SphereEGS/Sphere-X-Extension/Electronics/Step file/PCB.step

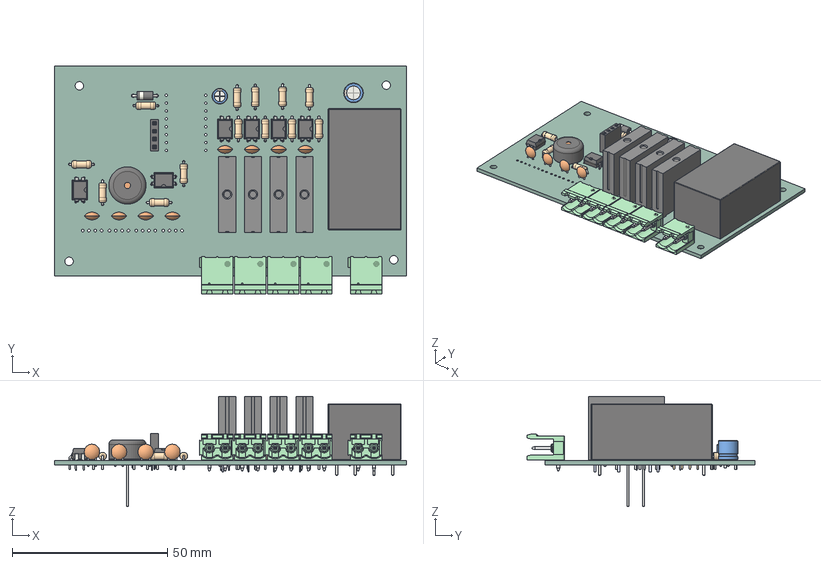
[picture p1: CAD file, 2025-05-03]
Electronics/Step file/PCB.step
113.3 x 73.2 x 35.5 mm
C_Disc_D5.0mm_W2.5mm_P2.50mm x 8
R_Axial_DIN0207_L6.3mm_D2.5mm_P7.62mm_Horizontal x 13
PinSocket_1x04_P2.54mm_Vertical
DIP-4_W7.62mm x 6
Converter_ACDC_Hi-Link_HLK-5Mxx
G3MB-202P x 4
Buzzer_TDK_PS1240P02BT_D12.2mm_H6.5mm
pin_01 x 5
pin_02 x 5
CP_Radial_D5.0mm_P2.50mm
D_DO-41_SOD81_P7.62mm_Horizontal
CP_Radial_D6.3mm_P2.50mm
Electronics_PCB
