SphereEGS/Sphere-X-Extension/Electronics/PDF/silk.pdf

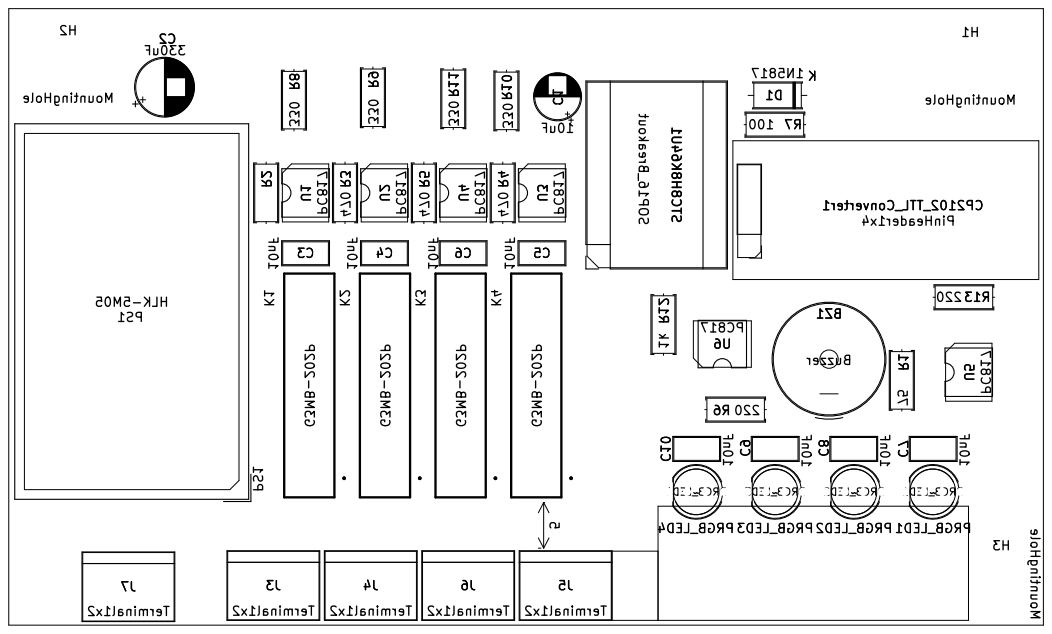
[picture p2: page 1]
