SphereEGS/Sphere-X-Extension/Electronics/PDF/trace.pdf

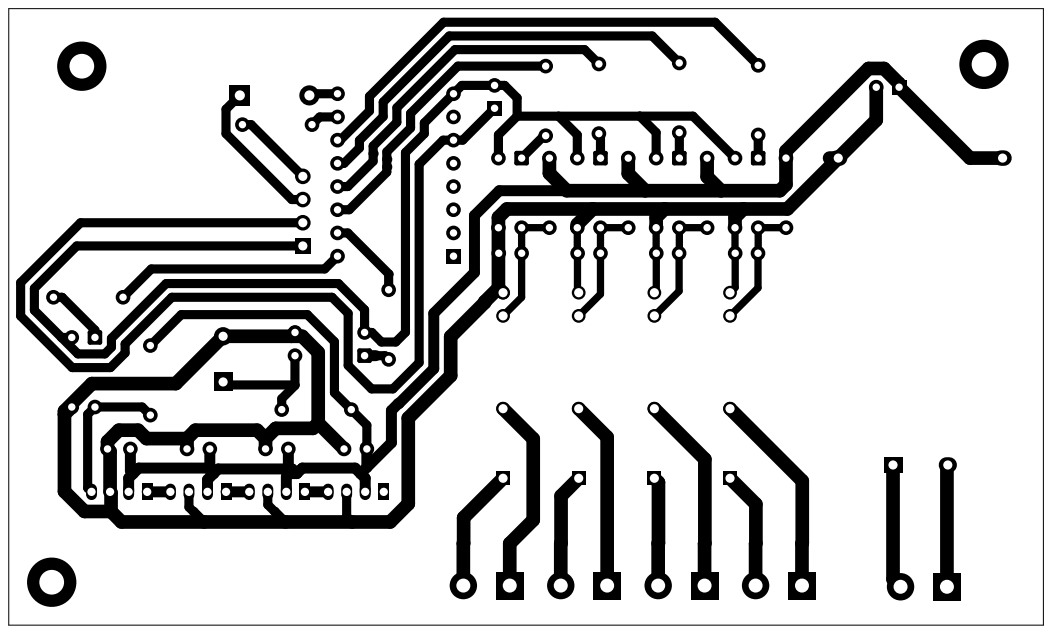
[picture p3: page 1]
