SphereEGS/Sphere-X-Extension/Electronics/Electronics.kicad_pcb

## KiCad design Electronics/Electronics.kicad_pcb (2025-05-08)

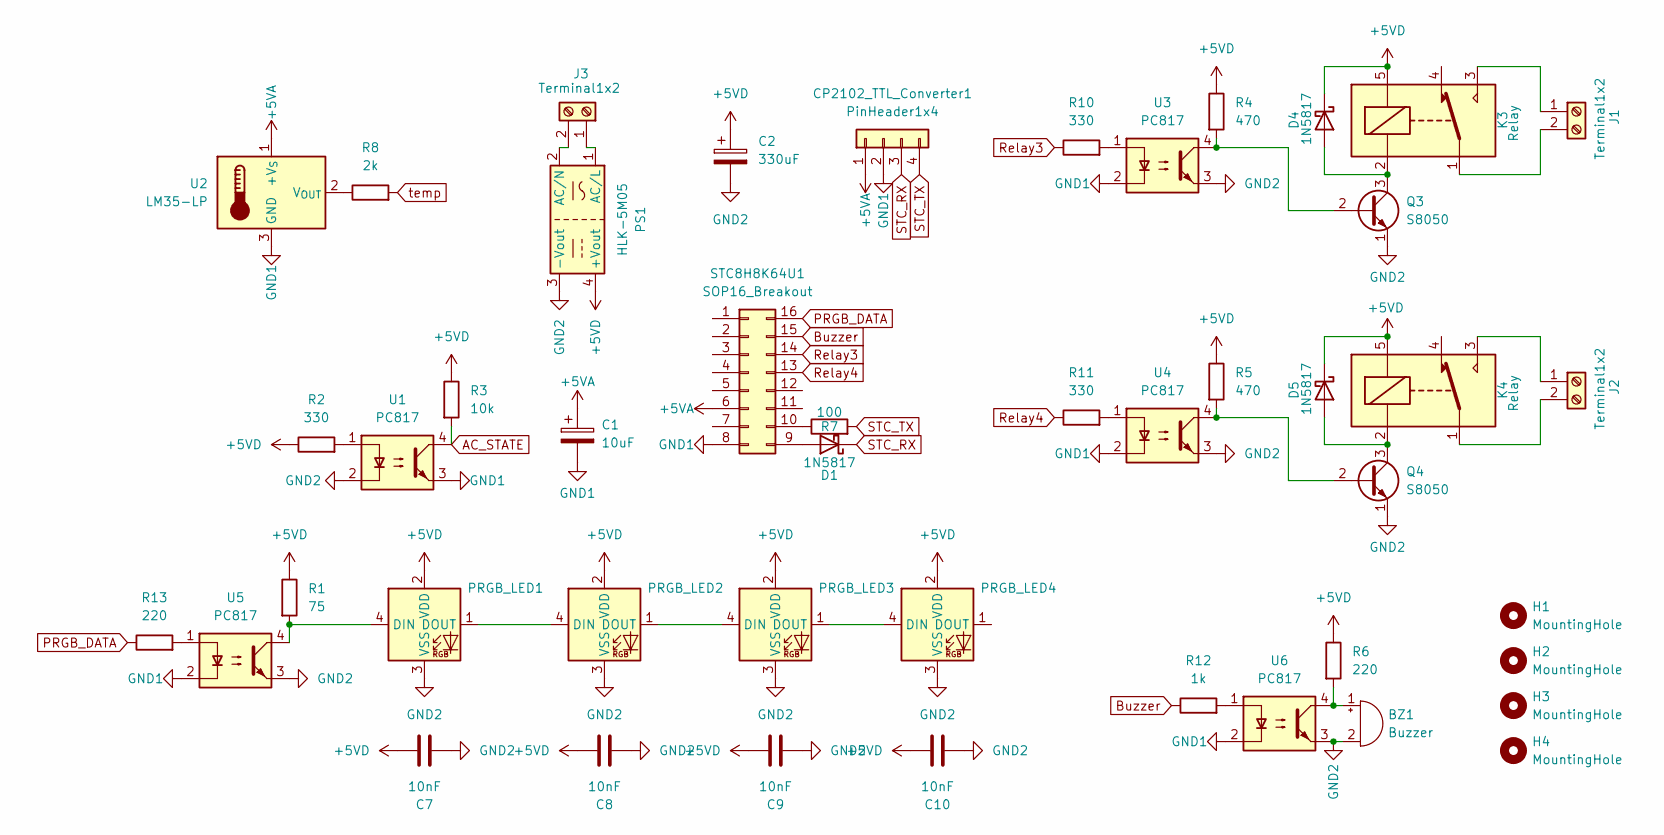
[picture p4: schematic Electronics.kicad_sch]

Parts:
BZ1: Buzzer; Buzzer_TDK_PS1240P02BT_D12.2mm_H6.5mm
C1: 10uF; CP_Radial_D5.0mm_P2.50mm
C2: 330uF; CP_Radial_D6.3mm_P2.50mm
C7, C8, C9, C10: 10nF; C_Disc_D5.0mm_W2.5mm_P2.50mm
CP2102_TTL_Converter1: PinHeader1x4; PinSocket_1x04_P2.54mm_Vertical
D1, D4, D5: 1N5817; D_DO-41_SOD81_P7.62mm_Horizontal
H1, H2, H3, H4: MountingHole; MountingHole_2.7mm_Pad
J1, J2, J3: Terminal1x2; TerminalBlock_bornier-2_P5.08mm
K3, K4: Relay; Relay_SPDT_SANYOU_SRD_Series_Form_C
PRGB_LED1, PRGB_LED2, PRGB_LED3, PRGB_LED4: PRGB_LED_DIP_Wide
PS1: HLK-5M05; Converter_ACDC_Hi-Link_HLK-5Mxx
Q3, Q4: S8050; TO-92_Inline_Wide
R1: 75; R_Axial_DIN0207_L6.3mm_D2.5mm_P7.62mm_Horizontal
R2, R10, R11: 330; R_Axial_DIN0207_L6.3mm_D2.5mm_P7.62mm_Horizontal
R3: 10k; R_Axial_DIN0207_L6.3mm_D2.5mm_P7.62mm_Horizontal
R4, R5: 470; R_Axial_DIN0207_L6.3mm_D2.5mm_P7.62mm_Horizontal
R6, R13: 220; R_Axial_DIN0207_L6.3mm_D2.5mm_P7.62mm_Horizontal
R7: 100; R_Axial_DIN0207_L6.3mm_D2.5mm_P7.62mm_Horizontal
R8: 2k; R_Axial_DIN0207_L6.3mm_D2.5mm_P7.62mm_Horizontal
R12: 1k; R_Axial_DIN0207_L6.3mm_D2.5mm_P7.62mm_Horizontal
STC8H8K64U1: SOP16_Breakout; Pololu_Breakout-16_15.2x20.3mm
U1, U3, U4, U5, U6: PC817; DIP-4_W7.62mm
U2: LM35-LP; TO-92L_Inline_Wide

Connections:
+5VA: C1.1, CP2102_TTL_Converter1.1, STC8H8K64U1.6, U2.1 (+V_{S})
+5VD: C2.1, C7.2, C8.2, C9.2, C10.2, D4.1 (K), D5.1 (K), K3.5, K4.5, PRGB_LED1.2 (VDD), PRGB_LED2.2 (VDD), PRGB_LED3.2 (VDD), PRGB_LED4.2 (VDD), PS1.4 (+Vout), R1.1, R2.1, R3.1, R4.1, R5.1, R6.1
AC_STATE: R3.2, U1.4
Buzzer: R12.1, STC8H8K64U1.15
GND1: C1.2, CP2102_TTL_Converter1.2, STC8H8K64U1.8, U1.3, U2.3 (GND), U3.2, U4.2, U5.2, U6.2
GND2: BZ1.2 (-), C2.2, C7.1, C8.1, C9.1, C10.1, PRGB_LED1.3 (VSS), PRGB_LED2.3 (VSS), PRGB_LED3.3 (VSS), PRGB_LED4.3 (VSS), PS1.3 (-Vout), Q3.1 (E), Q4.1 (E), U1.2, U3.3, U4.3, U5.3, U6.3
unnamed: BZ1.1 (+), R6.2, U6.4
unnamed: D1.2 (A), STC8H8K64U1.9
unnamed: D4.2 (A), K3.2, Q3.3 (C)
unnamed: D5.2 (A), K4.2, Q4.3 (C)
unnamed: J1.1, K3.3
unnamed: J1.2, K3.1
unnamed: J2.1, K4.3
unnamed: J2.2, K4.1
unnamed: J3.1, PS1.1 (AC/L)
unnamed: J3.2, PS1.2 (AC/N)
unnamed: PRGB_LED1.4 (DIN), R1.2, U5.4
unnamed: PRGB_LED1.1 (DOUT), PRGB_LED2.4 (DIN)
unnamed: PRGB_LED2.1 (DOUT), PRGB_LED3.4 (DIN)
unnamed: PRGB_LED3.1 (DOUT), PRGB_LED4.4 (DIN)
unnamed: Q3.2 (B), R4.2, U3.4
unnamed: Q4.2 (B), R5.2, U4.4
unnamed: R2.2, U1.1
unnamed: R10.2, U3.1
unnamed: R11.2, U4.1
unnamed: R12.2, U6.1
unnamed: R13.2, U5.1
unnamed: R7.1, STC8H8K64U1.10
unnamed: R8.1, U2.2 (V_{OUT})
PRGB_DATA: R13.1, STC8H8K64U1.16
Relay3: R10.1, STC8H8K64U1.14
Relay4: R11.1, STC8H8K64U1.13
STC_RX: CP2102_TTL_Converter1.3, D1.1 (K)
STC_TX: CP2102_TTL_Converter1.4, R7.2
temp: R8.2

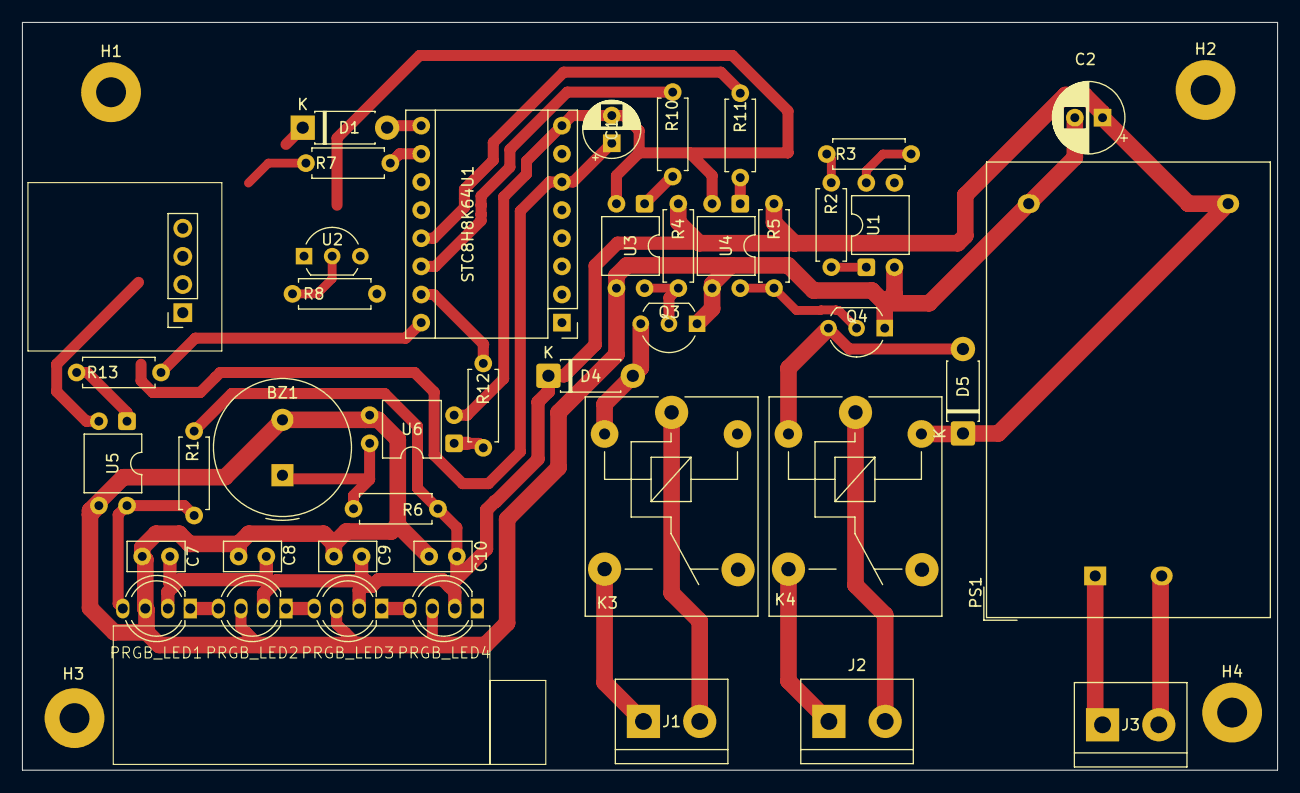
[picture p5: board Electronics.kicad_pcb from above]

Board: 2 copper layers, 113.3 x 67.5 mm, 46 parts (0 on the bottom side), 34 nets.
