SphereEGS/Sphere-X-Extension/Programming/stc_programming/terminal.c

#include "project-defs.h"

static command_t command;

// reads int only not floats and increments the char_count to the index of after the number
bool read_int(char *line, uint8_t* char_count, int16_t* int_value_ptr) {

  char *ptr = line + *char_count; // the variable that will extract the next digit from
  unsigned char c; // the variable that will hold each digit

  c = *ptr++;  // extracting the next digit!

  // catching negative values :)
  bool isnegative = false;
  if (c == '-') {
    isnegative = true;
    c = *ptr++;

  // incrementing pointer anyway if +ve sign is there
  } else if (c == '+') {
    c = *ptr++;
  }

  // Algorithm to convert char digits to int
  uint32_t intval = 0;
  uint8_t ndigit = 0;  // current digit read index
  int8_t exp = 0;  // NOT uint8_t as this must hold +ve and -ve numbers
  while (1) {

    c -= '0';
    if (c <= 9) {
      ndigit++;
      if (ndigit <= MAX_INT_DIGITS) {

        intval = (((intval << 2) + intval) << 1) + c; // intval*10 + c
                                                      //
      } else {

        exp++;  // Drop overflow digits
      }

    } else {
      // encountered a non integer character
      break;
    }
    c = *ptr++;
  }

  // Return if no digits have been read.
  if (!ndigit) { return(false); };

  long int lival;
  lival = (long int)intval;
  
  if (exp > 0) {
    do {
      lival *= 10.0;
    } while (--exp > 0);
  } 

  // Assign floating point value with correct sign.    
  if (isnegative) {
    *int_value_ptr = -lival;
  } else {
    *int_value_ptr = lival;
  }

  *char_count = ptr - line - 1; // Set char_counter to next statement
 
  return (true);
}

void command_reset(command_t* command) {
  command->command_type = COMMAND_NOT_SET;
  command->i = INT_ARGS_DEFAULT;
  command->j = INT_ARGS_DEFAULT;
  command->command_modal_status = COMMAND_NON_MODAL;
}

LINE_STATUS terminal_execute_line(char* line) {

  uint8_t char_count = 0;
  char letter;
  uint16_t int_value = 0;  // temporary int value that gets read from the terminal then assigned to another variable of any other c component

  // Resetting the command
  command_reset(&command);

  while (line[char_count] != 0) {

    /* [ Step 1: Capture read character and type check] */
    // Reading letter argument, aka which function to execute
    letter = line[char_count];

    // incrementing char_count for next iteration
    char_count++;

    // IMP: capital letters are command letters
    //      small letters are argument letters
    // Checking letter is a letter
    // checking if it's before A or after z or any character in between Z and a in the ascii table
    if ( letter < 'A' || letter > 'z' || (letter > 'Z' && letter < 'a')) {
      printf("\rExpected a letter!\n"); 
      return LINE_FAILED;
    }

    // small letter case is not a command, it's parameter
    if (!(letter >= 'a' && letter < 'z') && \
        (command.command_type != COMMAND_NOT_SET)) {
        printf("Can't have >1 command letter in one command!\n");
        return LINE_FAILED;
    }


    /* [ Step 2: Identify and Initiate command_t variable] */
    switch(letter) {

      case 'A':
        // testing reading int argument
        if (!read_int(line, &char_count, &int_value)) {
          printf("Bad integer Number Format\n");
          return LINE_FAILED;

        } 
        command.command_type = COMMAND_TEST_INT_READING;
        break;

      case 'T':
        command.command_type = COMMAND_GET_CURRENT_TIME;
        break;

      case 'R':
        command.command_type = COMMAND_RELAY_SET;
        break;

      case 'X':
        command.command_type = COMMAND_RELAY_TOGGLE;
        break;

      case 'L':
        command.command_type = COMMAND_LED;
        break;

      case 'i':
        // reading int argument for a multi-argument command
        if (!read_int(line, &char_count, &int_value)) {
          printf("Bad int Number Format\n");
          return LINE_FAILED;
        }
        command.i = int_value;
        break;

      case 'j':
        // reading int argument for a multi-argument command
        if (!read_int(line, &char_count, &int_value)) {
          printf("Bad int Number Format\n");
          return LINE_FAILED;
        }
        command.j = int_value;
        break;

      default:
        printf("Command Letter Not Implemented\n");
        return LINE_FAILED;
    }
  }

  /* [ Step 3: Error checking ] */
  switch(command.command_type) {

    case COMMAND_TEST_INT_READING:
    case COMMAND_GET_CURRENT_TIME:
      break;

    case COMMAND_RELAY_SET:
      if(command.i == INT_ARGS_DEFAULT) {
        printf("Error: Need to specific Relay Index 'i' argument\n");
        return LINE_FAILED;

      } else if(command.i >= RELAY_NUM) {
        printf("Error: Relay Index Out of range! (0 to %d)\n", RELAY_NUM-1);
        return LINE_FAILED;
      } 

      if ((command.j > 1) && (command.j != INT_ARGS_DEFAULT)) {
        printf("Error: Relay Value should be 0 or 1 only!\n");
        return LINE_FAILED;
      }
      break;

    case COMMAND_RELAY_TOGGLE:
      if(command.i == INT_ARGS_DEFAULT) {
        printf("Error: Need to specific Relay Index 'i' argument\n");
        return LINE_FAILED;

      } else if(command.i >= RELAY_NUM) {
        printf("Error: Relay Index Out of range! (0 to %d)\n", RELAY_NUM-1);
        return LINE_FAILED;
      } 
      break;

    case COMMAND_LED:
      if(command.i == INT_ARGS_DEFAULT) {
        printf("Error: Need to specific LED Index 'i' argument\n");
        return LINE_FAILED;

      } else if(command.i >= RELAY_NUM) {
        printf("Error: LED Index Out of range! (0 to %d)\n", LED_NUM-1);
        return LINE_FAILED;
      } 

      if ((command.j > SUPPORTED_COLORS_NUM) || (command.j == INT_ARGS_DEFAULT)) {
        printf("Error: Color Index Out of range!\nSupported color map\n0- COLOR_BLACK\n1- COLOR_RED\n2- COLOR_GREEN\n3- COLOR_BLUE\n4- COLOR_YELLOW\n5- COLOR_CYAN\n6- COLOR_MAGENTA\n7- COLOR_WHITE");

        return LINE_FAILED;
      }

      break;


    default:
      // if the command_type is not set (COMMAND_NOT_SET).
      // then a correct command wasn't passed in Step2.
      // which means that the default: of Step2 should run
      // so WTF?!??!
      printf("SHOULD NEVER REACH HERE IN ERROR CHECKING.\n");
      return LINE_FAILED;
  }

  /* [ Step 4: Execute! ] */
  switch(command.command_type) {

    case COMMAND_TEST_INT_READING:
      printf("Read INT value: %d\n", int_value);
      break;

    case COMMAND_GET_CURRENT_TIME:
      printf("Current Time Passed: %lu\n", get_current_time());
      break;

    case COMMAND_RELAY_SET:
      if(command.j == INT_ARGS_DEFAULT) {
        // Reading Relay state
        printf("Relay %d: %d\n", command.i, relay_get_state(command.i));


      } else {
        // Setting Relay states
        relay_set_state(command.i, command.j);

      }
      break;

    case COMMAND_RELAY_TOGGLE:
      relay_toggle(command.i);

    case COMMAND_LED:
      ws2812d_set_led_color(command.i, ind_to_color_map(command.j));
      break;

    default:
      // if the command_type is not set (COMMAND_NOT_SET).
      // then a correct command wasn't passed in Step2.
      // which means that the default: of Step2 should run
      // so WTF?!??!
      printf("SHOULD NEVER REACH HERE.");
      return LINE_FAILED;
  }

  return LINE_PASSED;
 
}
