SphereEGS/Sphere-X-Extension/Programming/stc_programming/buzzer.c

#include "project-defs.h"

static GpioConfig buzzer = GPIO_PIN_CONFIG(BUZZER_PORT, BUZZER_PIN, GPIO_BIDIRECTIONAL_MODE);

void buzzer_init(void) {

  // Initializing the buzzer pins
  gpioConfigure(&buzzer);

  // Setting ALL Pins to HIGH, Optocoupler means it's active low
  gpioWrite(&buzzer, 1);


}
