SphereEGS/Sphere-X-Extension/(commit log)

2025-04-30 added initial schematics
    [Electronics.kicad_pcb, Electronics.kicad_sch]
2025-04-30 finished STC Microcontroller Code structure and most init functions
    [Electronics.kicad_sch]
2025-05-01 finished circuit schematic, pin assignment, added inits of ws2812 PRGB LED
    [Electronics.kicad_pcb, Electronics.kicad_sch]
2025-05-02 finished C implementation of Relay Control
    [Electronics.kicad_sch]
2025-05-03 finished PCB layout
    [Electronics.kicad_pcb, Electronics.kicad_sch]
2025-05-03 added a force anchor hole for the PCB
    [Electronics.kicad_pcb, Electronics.kicad_sch]
2025-05-03 started 3D modelling enclosure
    [Electronics.kicad_pcb, Electronics.kicad_sch, PCB.step]
2025-05-04 updated pin assignments
2025-05-04 added mapping for new relays
2025-05-08 added schematic and PCB layout for mechanical relays
    [Electronics.kicad_pcb, Electronics.kicad_sch]
2025-05-08 added temperature sensor and AC detect schematic and PCB layout
    [Electronics.kicad_pcb, Electronics.kicad_sch]
